hyeongukryu/WaterTurret/README.md

WaterTurret
===========
화분을 구별할 수 있는 물 분사 시스템

작동 영상
--

- [식물 살수](http://www.youtube.com/watch?v=4O7ib85GOOE)
- [범위 살수](http://www.youtube.com/watch?v=7TxLnf3Ldrs)

등록 특허
--
+ 분사 시스템
+ 등록 특허 제10-1432678호

GPLv3 최고!
--

Copyright (C) 2013 류형욱

This program is free software: you can redistribute it and/or modify
it under the terms of the GNU General Public License as published by
the Free Software Foundation, either version 3 of the License, or
(at your option) any later version.

This program is distributed in the hope that it will be useful,
but WITHOUT ANY WARRANTY; without even the implied warranty of
MERCHANTABILITY or FITNESS FOR A PARTICULAR PURPOSE.  See the
GNU General Public License for more details.

You should have received a copy of the GNU General Public License
along with this program.  If not, see <http://www.gnu.org/licenses/>.

의존하는 라이브러리
--
+ LGPL v3 License에 따라서 배포되는 AForge.NET를 .NET 어셈블리로 참조합니다.
+ GNU LGPL에 따라서 배포되는 OpenCvSharp를 .NET 어셈블리로 참조하며, OpenCvSharp은 BSD License에 따라서 배포되는 OpenCV에 의존합니다.
+ Microsoft Public License에 따라서 배포되는 Microsoft Unity 2.1
+ Microsoft Prism 4
