hyeongukryu/WaterTurret/host/WaterTurret/WaterTurret.Module/Readme.txt

Prism WPF 4.0 Module Project
----------------------------

Next Steps:
Update your Shell project's ModuleCatalog.xaml file to load this Module into the Shell.

Note:
Prism 4.0 provides signed binary assemblies. To ensure that project references are resolved correctly,
register the Prism assemblies with Visual Studio by running the RegisterPrismBinaries batch file.

For the latest information on Prism, see www.codeplex.com/prism.
