hyeongukryu/WaterTurret/art/black, white.pdf

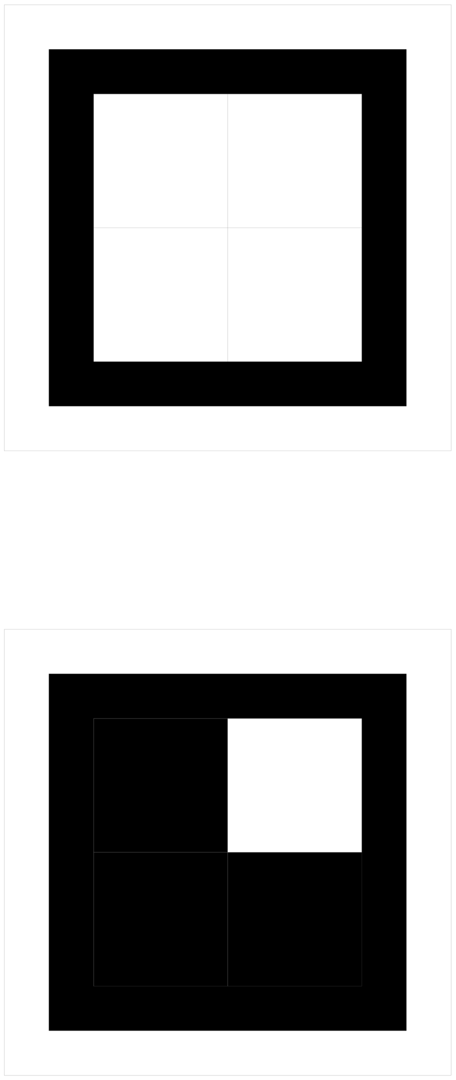
[picture p16: page 1]
