hyeongukryu/WaterTurret/art/Marker/Marker0001.pdf

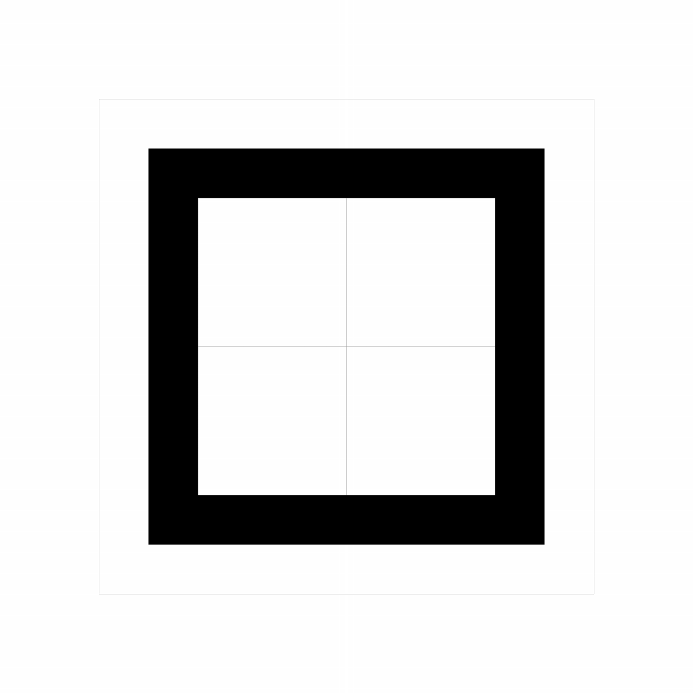
[picture p17: figure]
