hyeongukryu/WaterTurret/art/Marker/Marker0002.pdf

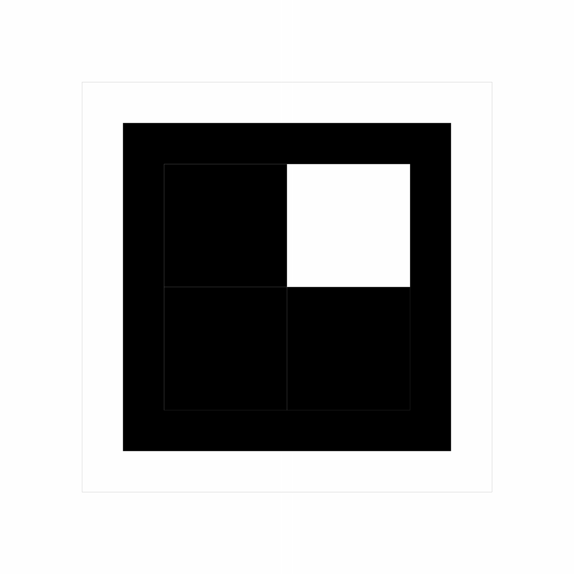
[picture p18: figure]
