hyeongukryu/WaterTurret/art/Marker/Marker0003.pdf

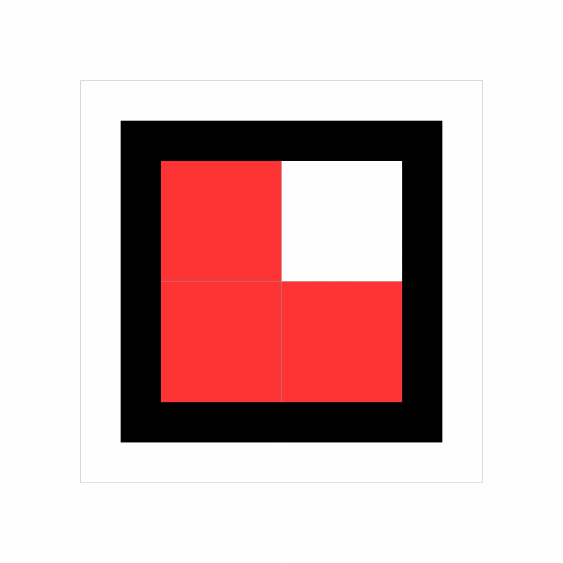
[picture p19: figure]
