hyeongukryu/WaterTurret/art/Marker/Marker0004.pdf

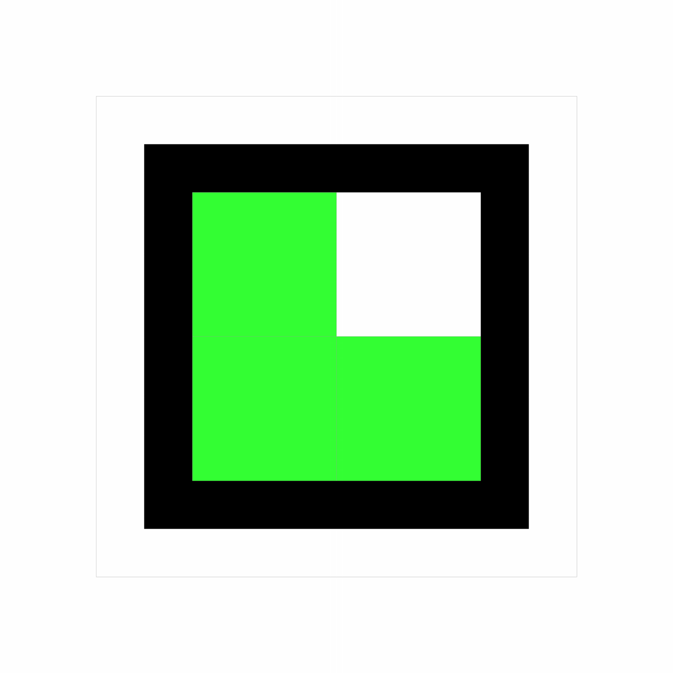
[picture p20: figure]
