hyeongukryu/WaterTurret/art/Marker/Marker0005.pdf

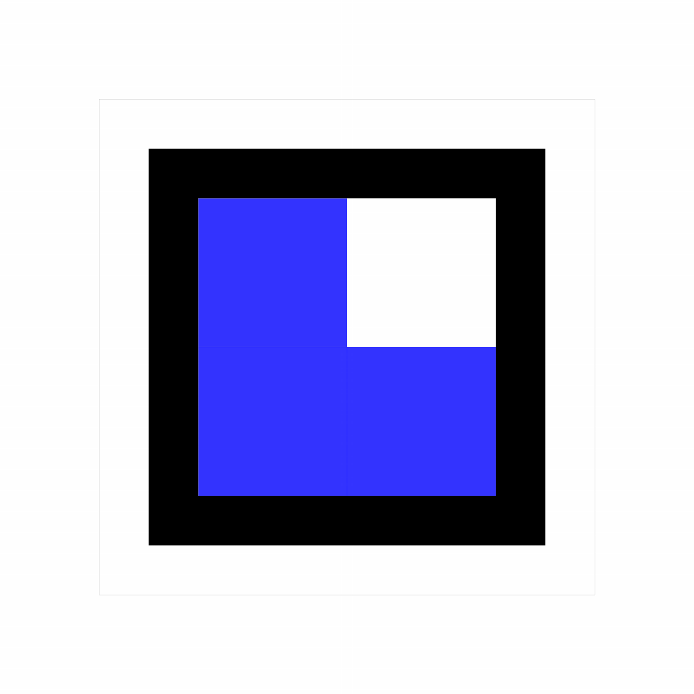
[picture p21: figure]
