hyeongukryu/WaterTurret/art/MarkerSmall/Marker0003.pdf

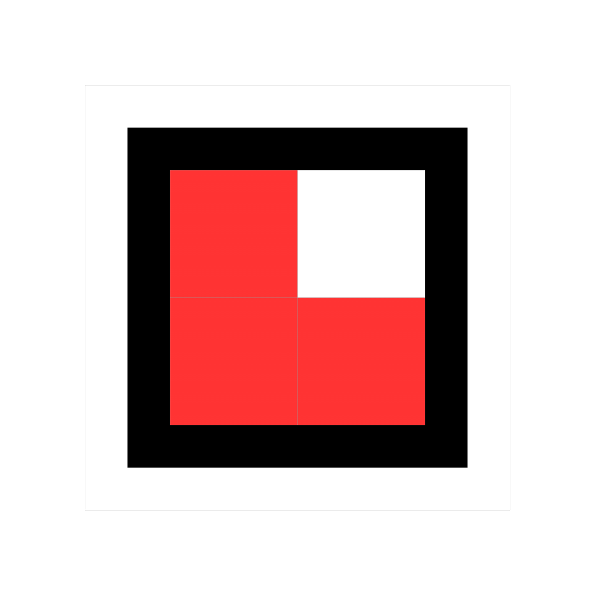
[picture p22: figure]
