hyeongukryu/WaterTurret/art/MarkerSmall/Marker0004.pdf

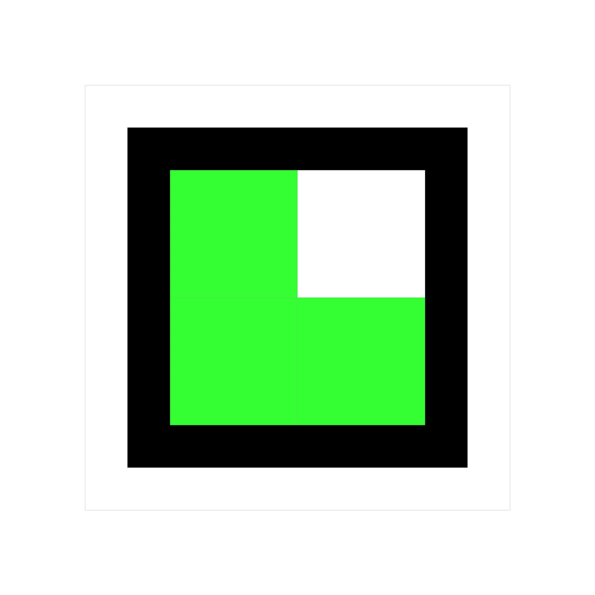
[picture p23: figure]
