hyeongukryu/WaterTurret/art/MarkerSmall2/1.pdf

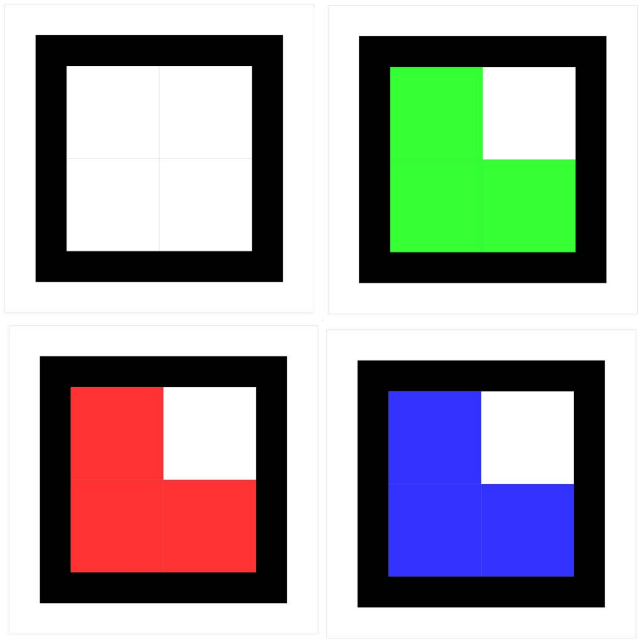
[picture p24: page 1]
