hyeongukryu/WaterTurret/art/MarkerSmall2/2.pdf

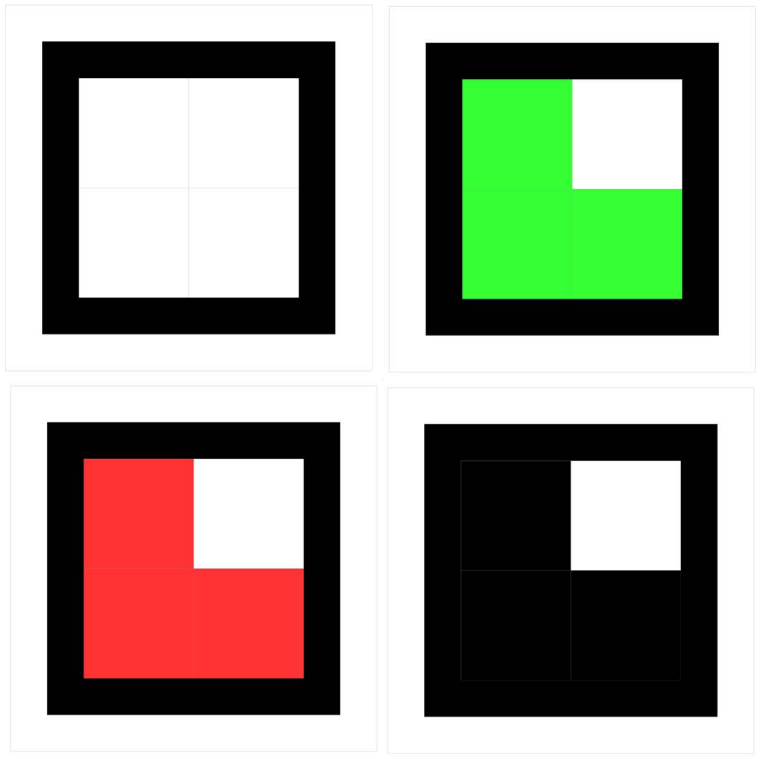
[picture p25: page 1]
