hyeongukryu/WaterTurret/art/MarkerOld/Marker0001.pdf

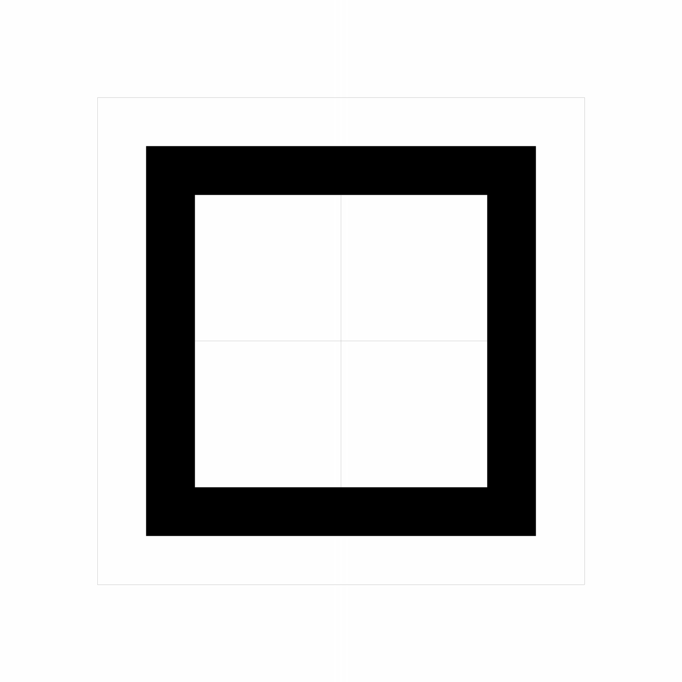
[picture p26: figure]
