hyeongukryu/WaterTurret/art/MarkerOld/Marker0002.pdf

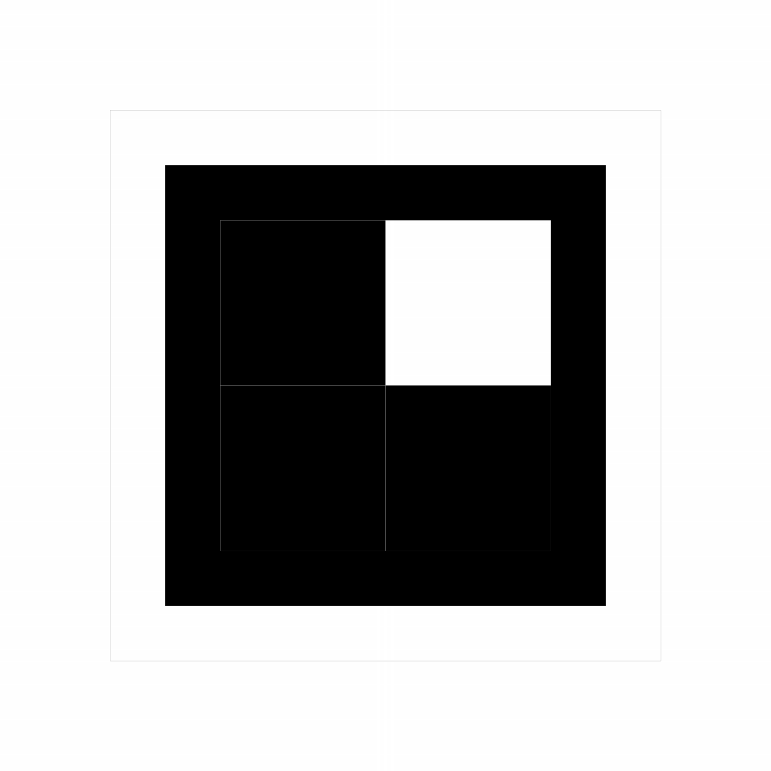
[picture p27: figure]
