hyeongukryu/WaterTurret/art/MarkerOld/Marker0003.pdf

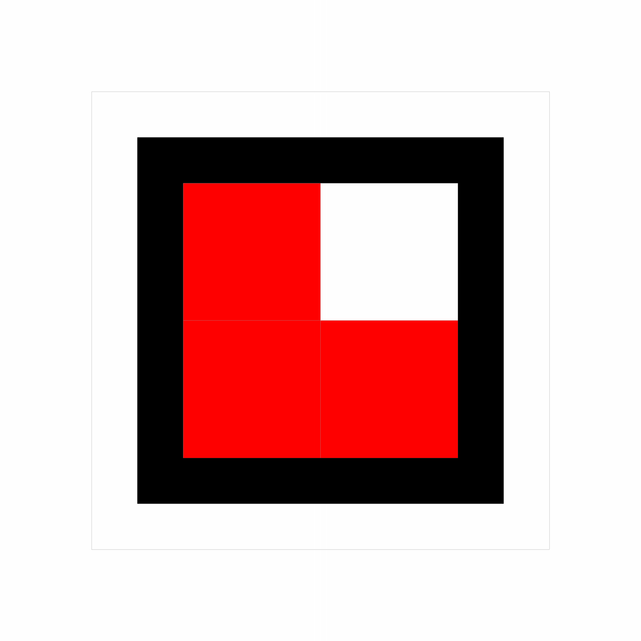
[picture p28: figure]
