hyeongukryu/WaterTurret/art/MarkerOld/Marker0004.pdf

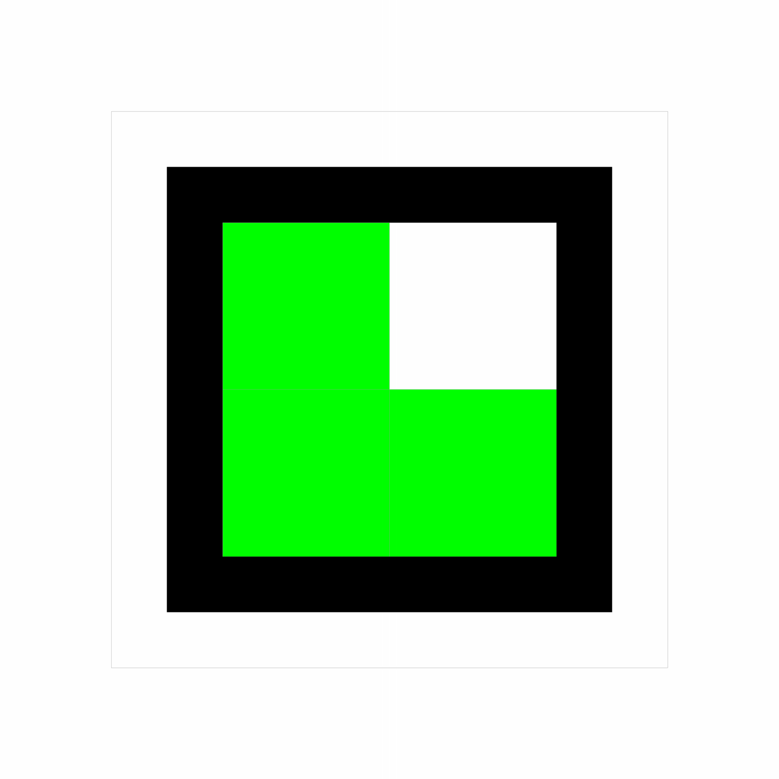
[picture p29: figure]
