hyeongukryu/WaterTurret/art/MarkerOld/Marker0005.pdf

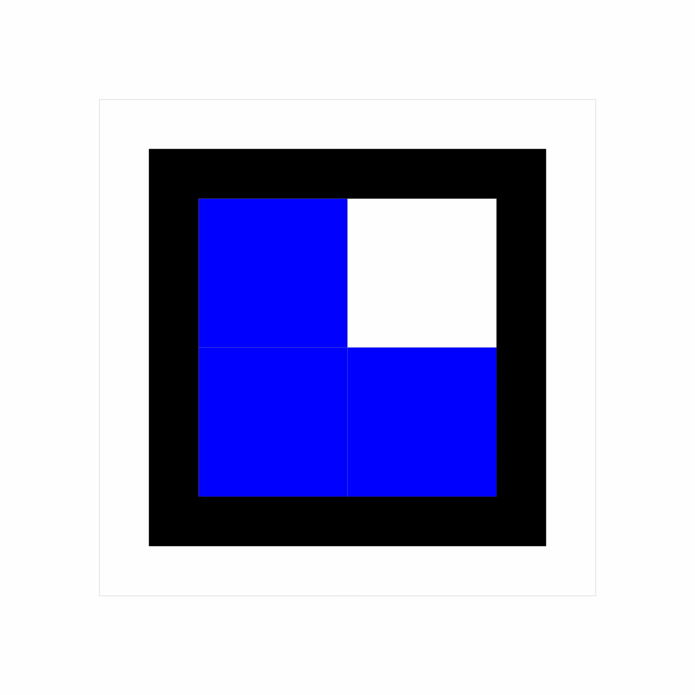
[picture p30: figure]
