hyeongukryu/WaterTurret/art/Marker/Marker.png

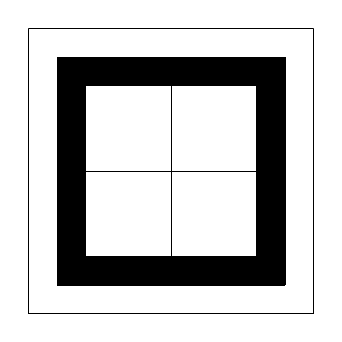
art/Marker/Marker.png
