hyeongukryu/WaterTurret/paper/img/SDC10178.JPG

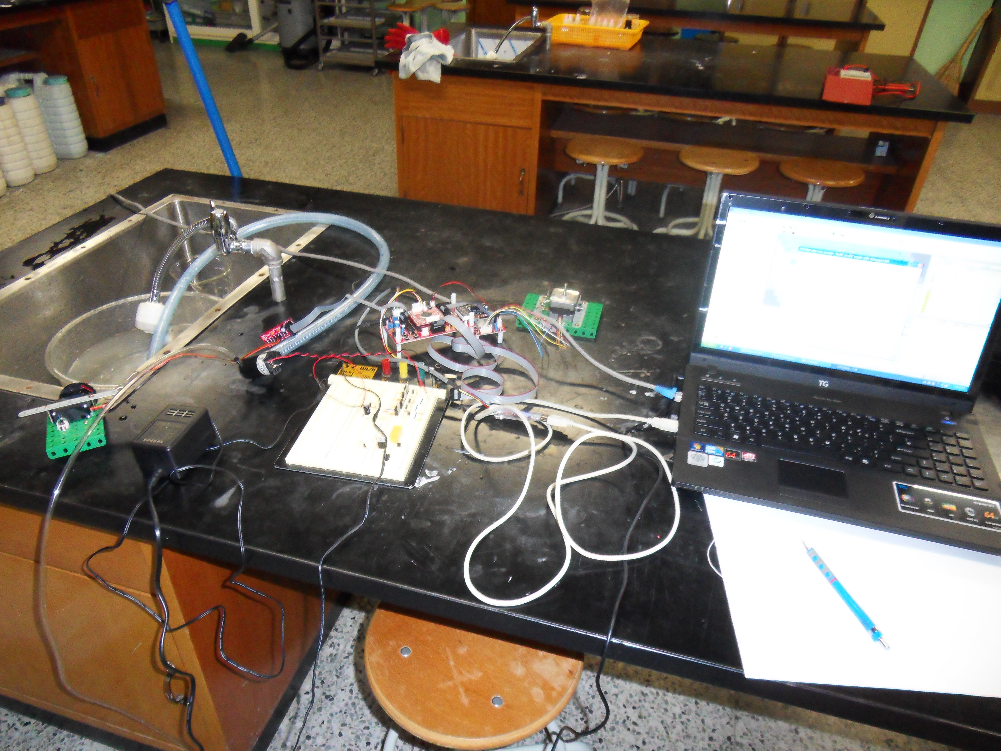
paper/img/SDC10178.JPG
