hyeongukryu/WaterTurret/paper/img/SNC00446.jpg

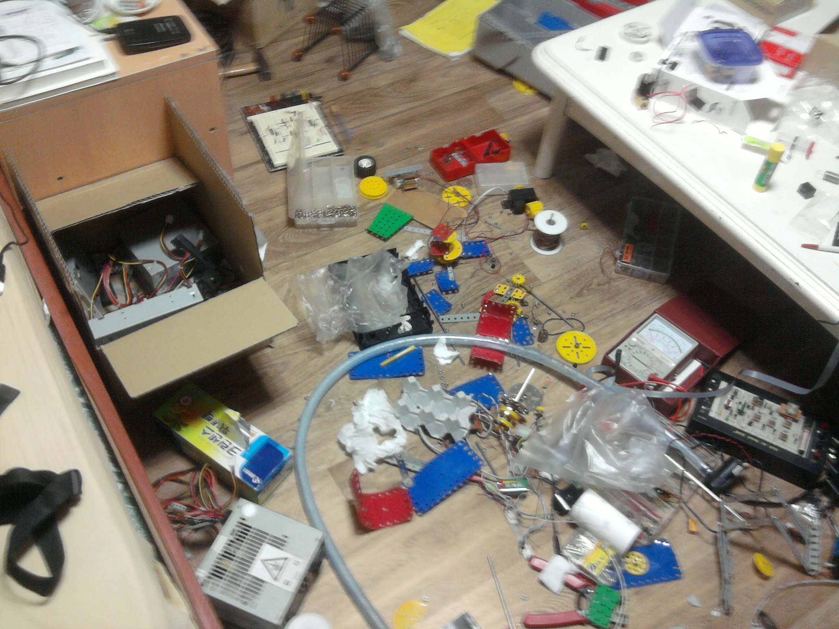
paper/img/SNC00446.jpg
