hyeongukryu/WaterTurret/paper/img/SNC00447.jpg

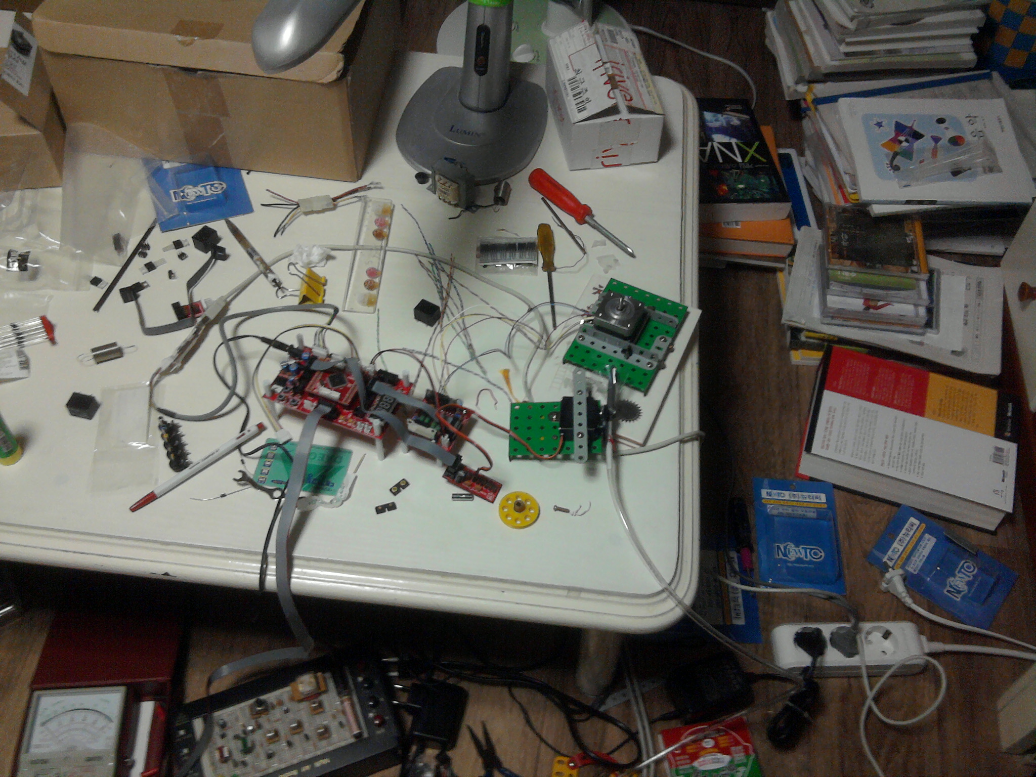
paper/img/SNC00447.jpg
