hyeongukryu/WaterTurret/paper/img/SNC00527.jpg

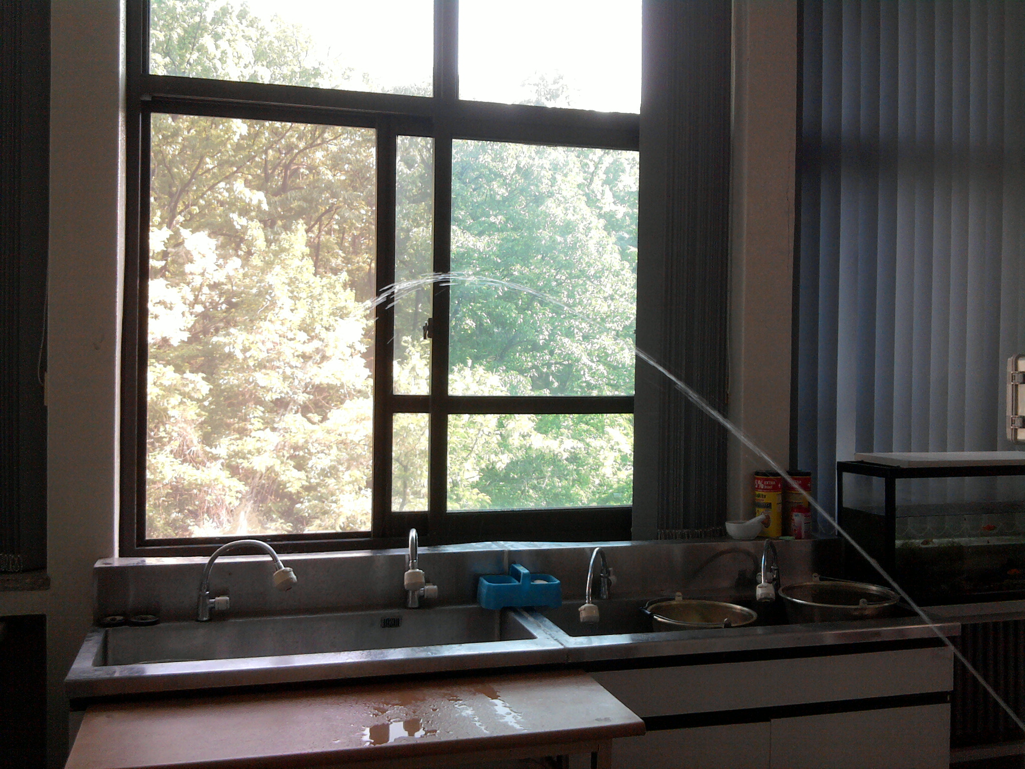
paper/img/SNC00527.jpg
