hyeongukryu/WaterTurret/paper/img/title.png

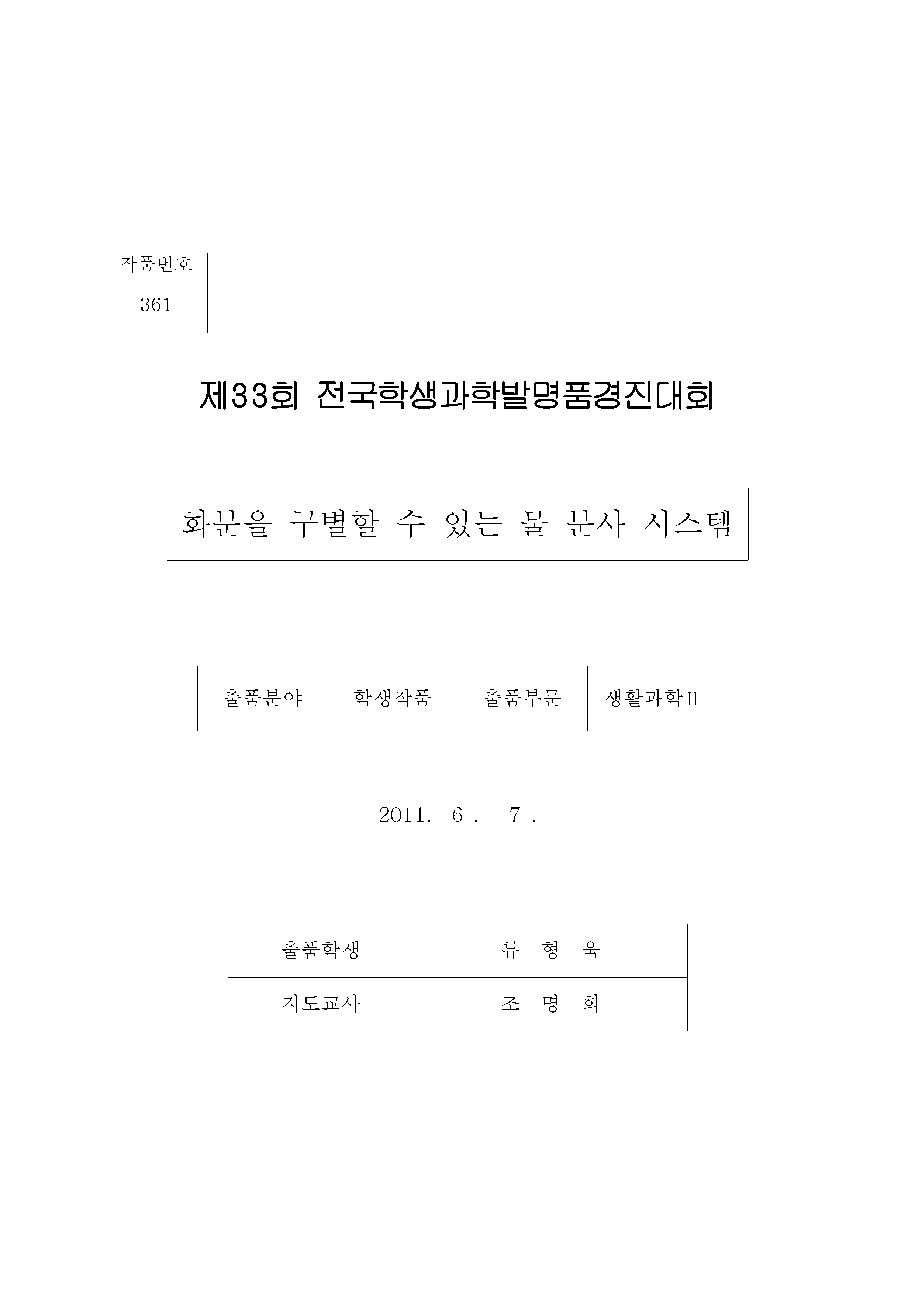
paper/img/title.png
