hyeongukryu/WaterTurret/host/WaterTurret/camera.yml

%YAML:1.0
calibration_time: "07/04/11 16:41:39"
nframes: 29
image_width: 1280
image_height: 720
board_width: 10
board_height: 7
square_size: 2.3499999046325684e+000
flags: 0
camera_matrix: !!opencv-matrix
   rows: 3
   cols: 3
   dt: d
   data: [ 1.1695655098541806e+003, 0., 6.4021954013608831e+002, 0.,
       1.1681617080034912e+003, 3.9445679861269389e+002, 0., 0., 1. ]
distortion_coefficients: !!opencv-matrix
   rows: 5
   cols: 1
   dt: d
   data: [ 2.6841494346043832e-001, -1.2536264991327042e+000,
       -5.1949753225457767e-003, 3.4873327984947492e-003,
       1.6164704855540843e+000 ]
avg_reprojection_error: 3.2807012792565288e-001
per_view_reprojection_errors: !!opencv-matrix
   rows: 29
   cols: 1
   dt: f
   data: [ 3.81131828e-001, 2.82696605e-001, 3.52148265e-001,
       3.65177691e-001, 2.44466364e-001, 2.99539208e-001,
       3.81719649e-001, 2.79715598e-001, 2.19788492e-001,
       3.93492848e-001, 2.96130300e-001, 2.84331679e-001,
       2.66248316e-001, 4.04790401e-001, 3.08218300e-001,
       2.94389635e-001, 3.95363897e-001, 2.91143030e-001,
       4.16666090e-001, 2.86990434e-001, 3.96297008e-001,
       3.39870870e-001, 2.96680152e-001, 2.34294027e-001,
       2.45523453e-001, 3.51342857e-001, 3.56405944e-001,
       3.31020802e-001, 3.79935086e-001 ]
# a set of 6-tuples (rotation vector + translation vector) for each view
extrinsic_parameters: !!opencv-matrix
   rows: 29
   cols: 6
   dt: f
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
       3.97190613e+002, 2.44445297e+002, 4.78152191e+002,
       2.81261719e+002, 4.73785583e+002, 3.18532471e+002,
       4.69447937e+002, 3.57002747e+002, 4.65249878e+002,
       3.95910919e+002, 4.61014618e+002, 4.34720856e+002,
       4.56502380e+002, 4.73620544e+002, 4.51829559e+002,
       5.13471375e+002, 4.46982483e+002, 5.53483032e+002,
       4.42246094e+002, 5.93859985e+002, 4.37158875e+002,
       2.41306427e+002, 5.17146606e+002, 2.78484985e+002,
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
