hyeongukryu/WaterTurret/host/WaterTurret/out_camera_data.yml

%YAML:1.0
calibration_time: "06/27/11 01:05:43"
nframes: 15
image_width: 1280
image_height: 720
board_width: 10
board_height: 7
square_size: 2.4000000953674316e+000
flags: 0
camera_matrix: !!opencv-matrix
   rows: 3
   cols: 3
   dt: d
   data: [ 1.1442471246455027e+003, 0., 6.4812020158754228e+002, 0.,
       1.1443391554606812e+003, 3.8794788696276186e+002, 0., 0., 1. ]
distortion_coefficients: !!opencv-matrix
   rows: 5
   cols: 1
   dt: d
   data: [ 2.0156935445340091e-001, -1.0814314304293935e+000,
       -6.7653166226057113e-003, 3.7355841949211124e-003,
       1.7023014402148473e+000 ]
avg_reprojection_error: 3.4880936212493235e-001
per_view_reprojection_errors: !!opencv-matrix
   rows: 15
   cols: 1
   dt: f
   data: [ 3.54123831e-001, 2.81160563e-001, 3.10298234e-001,
       4.38771516e-001, 4.49284703e-001, 3.12982470e-001,
       2.71794260e-001, 2.59105146e-001, 2.63758242e-001,
       3.49278659e-001, 2.77234882e-001, 3.99508119e-001,
       4.16164786e-001, 2.93393046e-001, 4.51258600e-001 ]
# a set of 6-tuples (rotation vector + translation vector) for each view
extrinsic_parameters: !!opencv-matrix
   rows: 15
   cols: 6
   dt: d
   data: [ 3.3788194196402482e-001, 5.6124173969432301e-001,
       3.0408112613638774e+000, 2.2524092518647151e+001,
       8.3733851451319943e+000, 6.2320041604342499e+001,
       4.7836719656882021e-001, 3.8850111235124107e-001,
       3.0443094152124903e+000, 1.0260307571654042e+001,
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
       3.44541077e+002, 9.12763062e+002, 3.47886871e+002,
       8.70893860e+002, 3.51065338e+002, 8.29833008e+002,
       3.54359100e+002, 7.89725952e+002, 3.57291901e+002,
       7.50392334e+002, 3.60440155e+002, 7.11432190e+002,
       3.63260468e+002, 6.73367859e+002, 3.65960999e+002,
       1.03862451e+003, 2.99483490e+002, 9.95233521e+002,
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
