hyeongukryu/WaterTurret/embedded/WaOS/waos/waos.h

#ifndef _WAOS
#define _WAOS

#include <stdio.h>
#include <stdlib.h>
#include <stdint.h>
#include <string.h>

#include <avr/io.h>
#include <avr/interrupt.h>


#include "waos_flag.h"

#include "waos_const.h"
#include "waos_util.h"
#include "waos_context.h"
#include "waos_error.h"
#include "waos_memory.h"
#include "waos_serial.h"
#include "waos_task.h"
#include "waos_timer.h"
#include "waos_port.h"
#include "waos_version.h"


#endif
