hyeongukryu/WaterTurret/(commit log)

2013-06-03 README.md 수정
2013-06-04 GPLv3 최고!
2013-06-04 의존하는 라이브러리 수정
2013-06-04 ATmega128A 데이터시트 추가
2013-06-04 작품 설명서 추가
2013-06-04 WaOS 기존 프로젝트 추가
2013-06-04 WaterTurret3 기존 프로젝트 추가
2013-06-04 WaterTurret4 기존 프로젝트 추가
2013-06-04 art 기존 자료 추가
2013-06-04 README.md 의존하는 라이브러리 수정
2013-06-04 WaterTurret 기존 프로젝트 추가
2013-06-04 AForge breaking change 대응
2013-06-04 빈 디렉토리 포함
2013-06-04 빈 디렉토리 추가
2014-09-08 Update README.md
    등록 특허
